hexeguitar/Tadek-Compressor/pics/tadek5.jpg

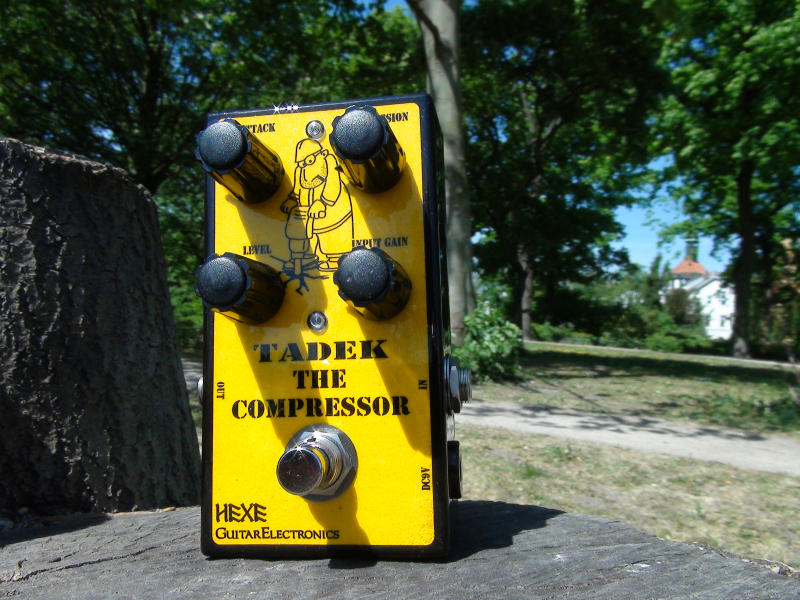
pics/tadek5.jpg
