hexeguitar/Tadek-Compressor/pics/Tadek_v2_pcb1.jpg

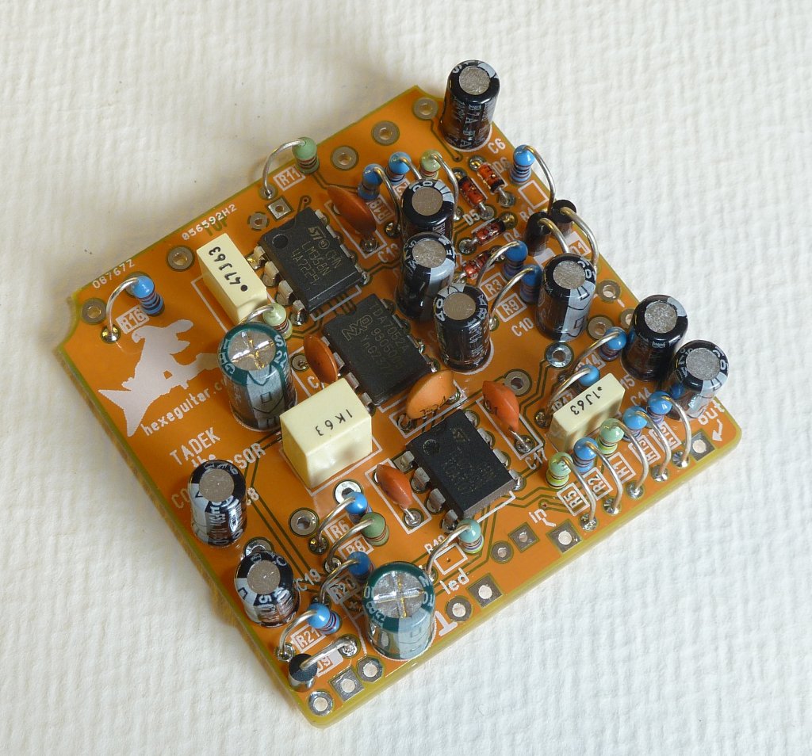
pics/Tadek_v2_pcb1.jpg
