hexeguitar/Tadek-Compressor/README.md

Tadek-Compressor
================

HEXE Tadek Compressor DIY pedal

TDA7052A based guitar/bass compressor pedal.
http://www.hexeguitar.com/diy/gear/tadek
