hexeguitar/Tadek-Compressor/pics/Tadek_v2_pcb2.jpg

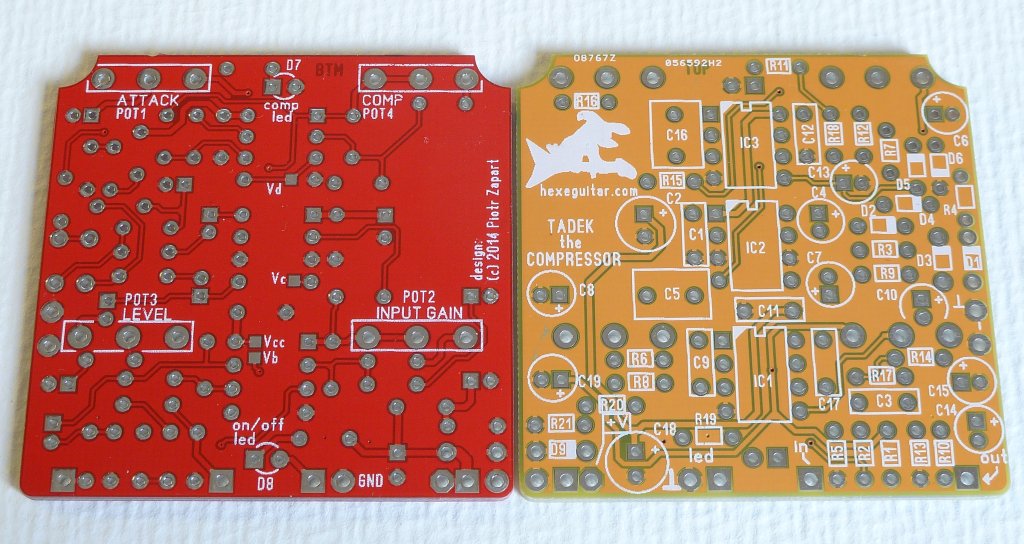
pics/Tadek_v2_pcb2.jpg
