hexeguitar/Tadek-Compressor/design_files/HEXE_Tadek_v2-PCB-assembly.pdf

# TADEK The COMPRESSOR v. 2.0

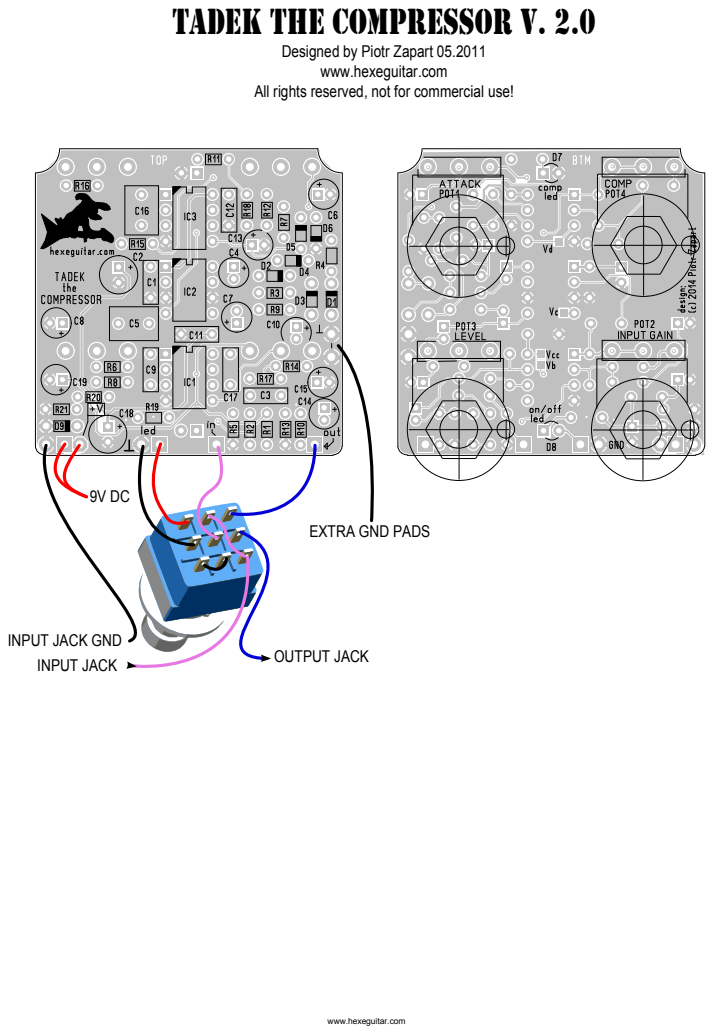
[picture p5: page 1]
INPUT JACK; OUTPUT JACK

Designed by Piotr Zapart 05.2011
www.hexeguitar.com

All rights reserved, not for commercial use!

EXTRA GND PADS

INPUT JACK GND
