hexeguitar/Tadek-Compressor/design_files/HEXE-Tadek-v2-schm.pdf

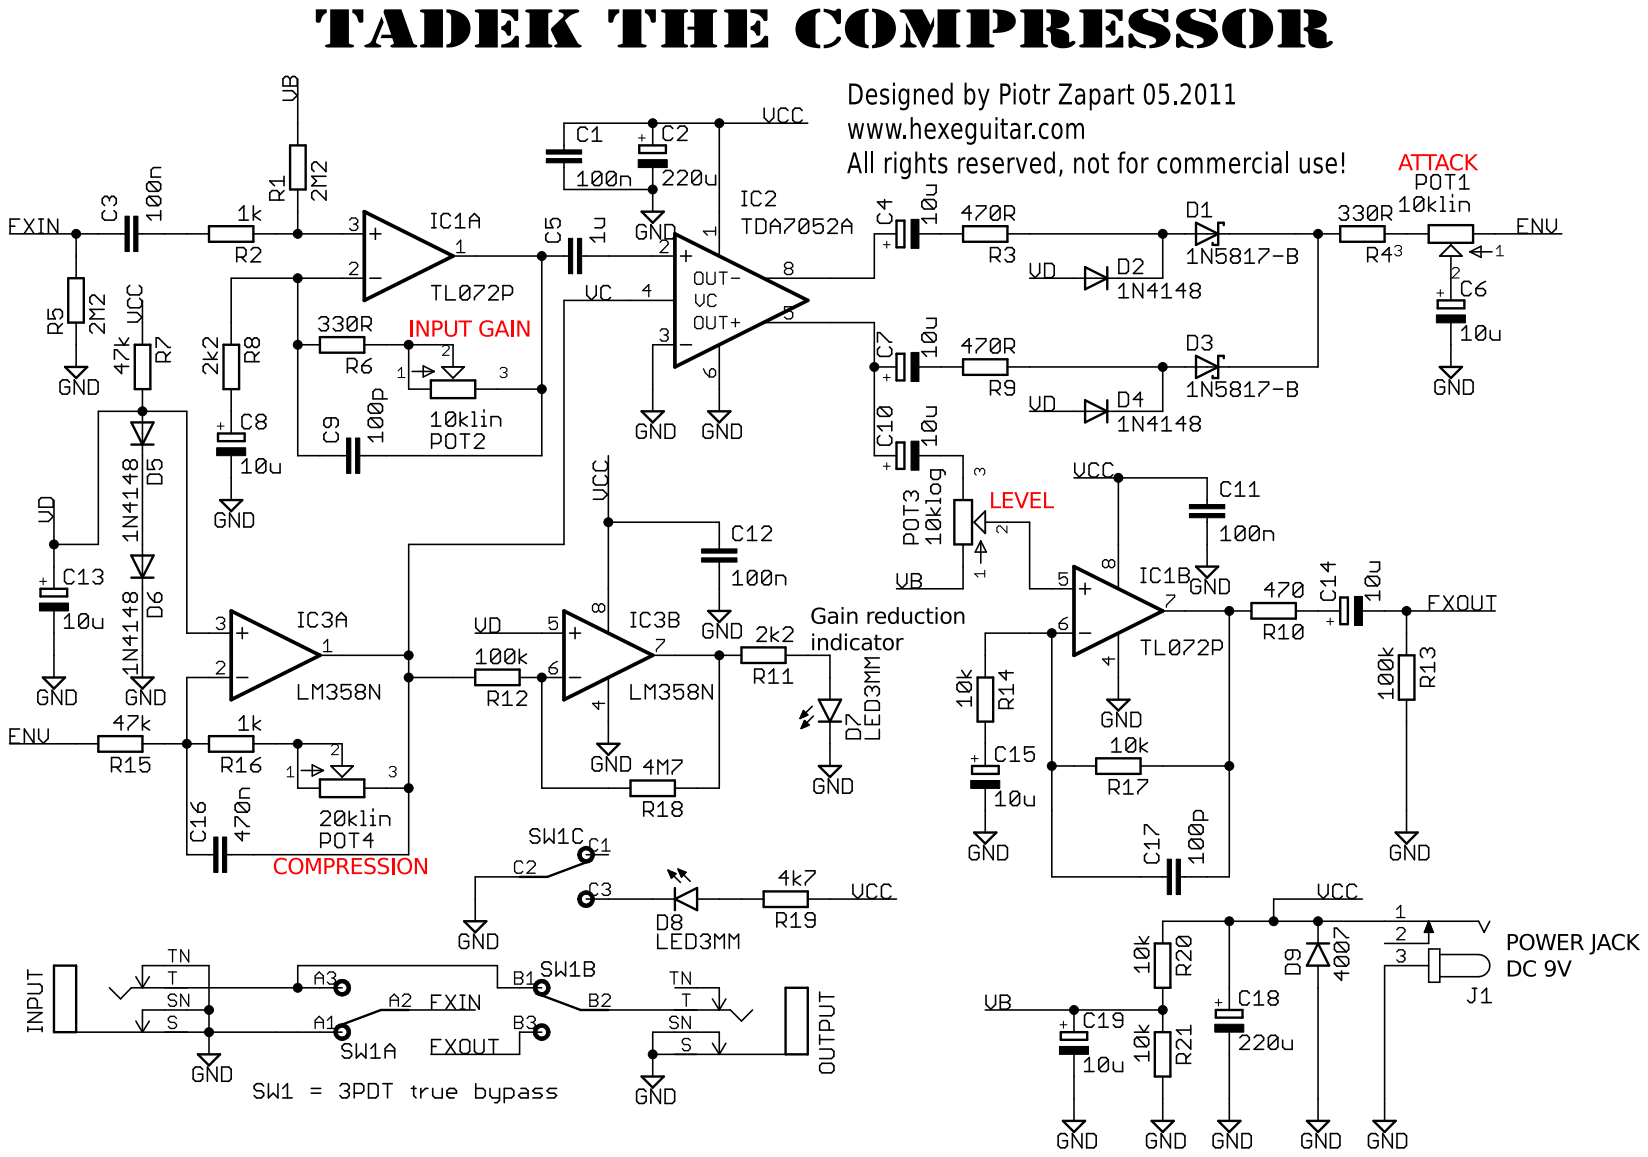
[picture p6: page 1]
