hexeguitar/Tadek-Compressor/(commit log)

2014-08-28 1st upload
    [tdkc.GBL, tdkc.GBO, tdkc.GBS, tdkc.GTL, tdkc.GTO, tdkc.GTS]
2015-08-20 Corrected mistake on the schematic
    R7 goes up to VCC instad of VC, PCB design is correct.
